Canditos/GLICOMETER/docs/assets/bateria_21700_interior.png

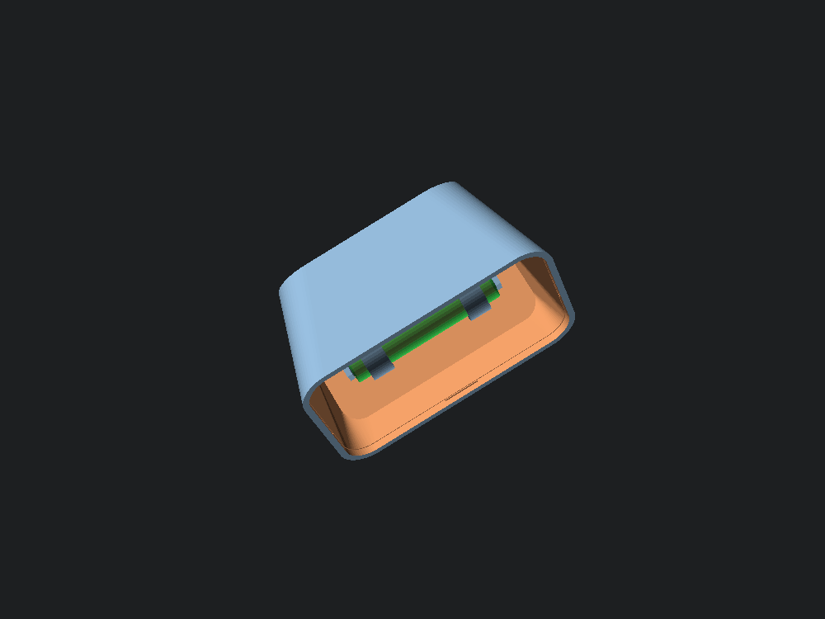
docs/assets/bateria_21700_interior.png
