Canditos/GLICOMETER/docs/assets/corpo_deitado_stl_interior.png

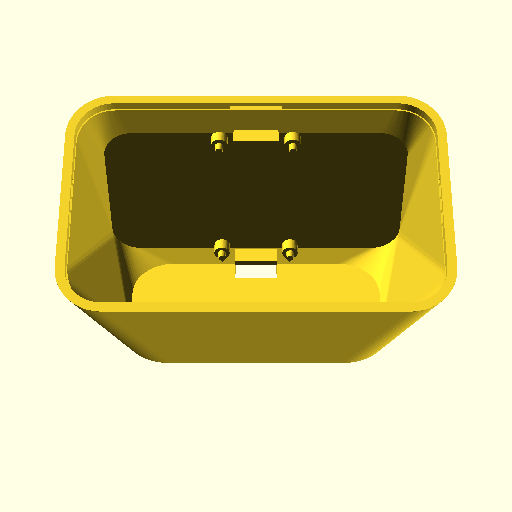
docs/assets/corpo_deitado_stl_interior.png
