Canditos/GLICOMETER/docs/assets/grelha_speaker_traseira.png

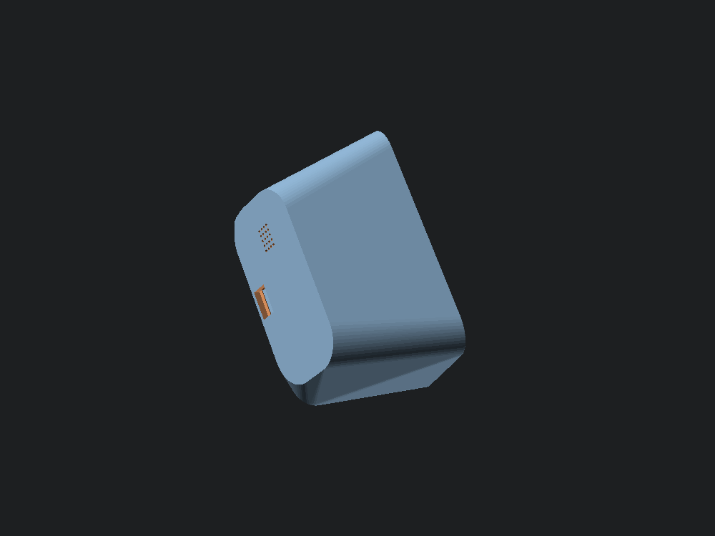
docs/assets/grelha_speaker_traseira.png
