Canditos/GLICOMETER/docs/assets/moldura_43_polegadas.png

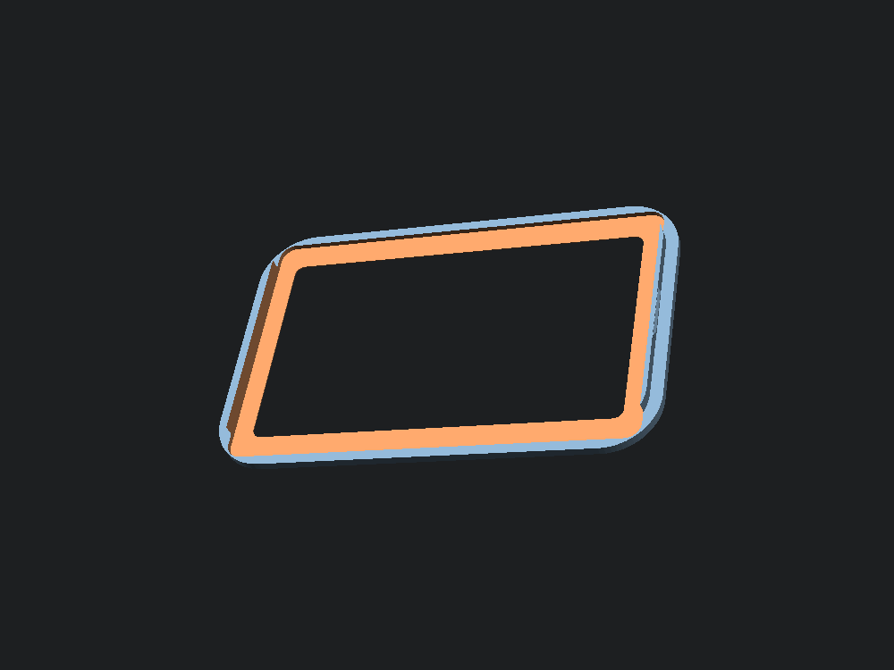
docs/assets/moldura_43_polegadas.png
