Canditos/GLICOMETER/docs/assets/moldura_frente_lisa.png

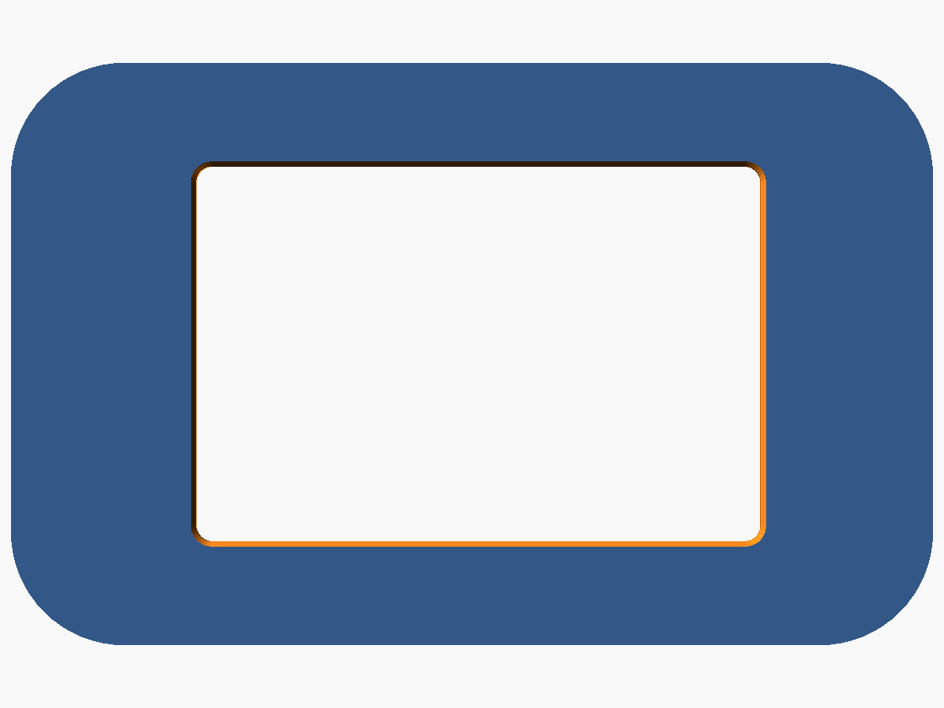
docs/assets/moldura_frente_lisa.png
