Canditos/GLICOMETER/docs/previews/preview_corpo.png

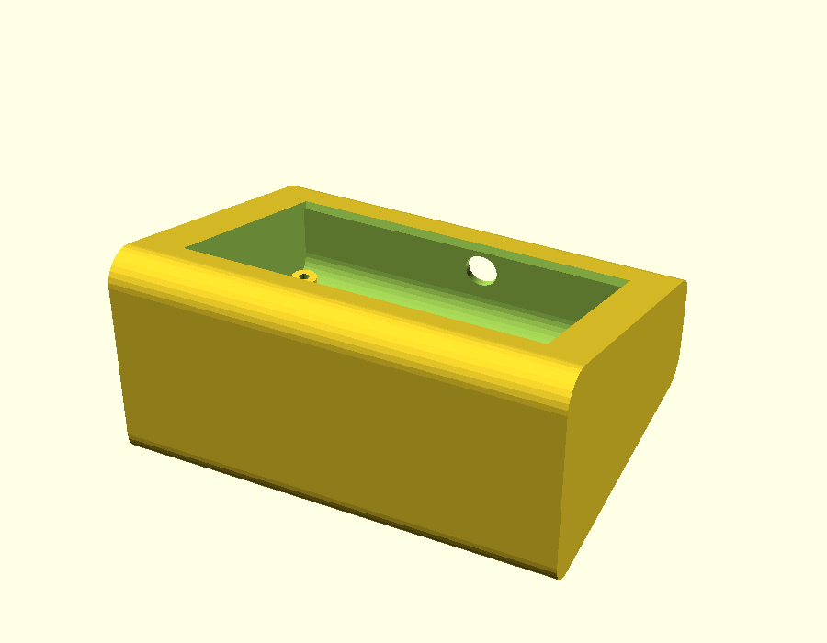
docs/previews/preview_corpo.png
