Canditos/GLICOMETER/docs/previews/preview_placa.png

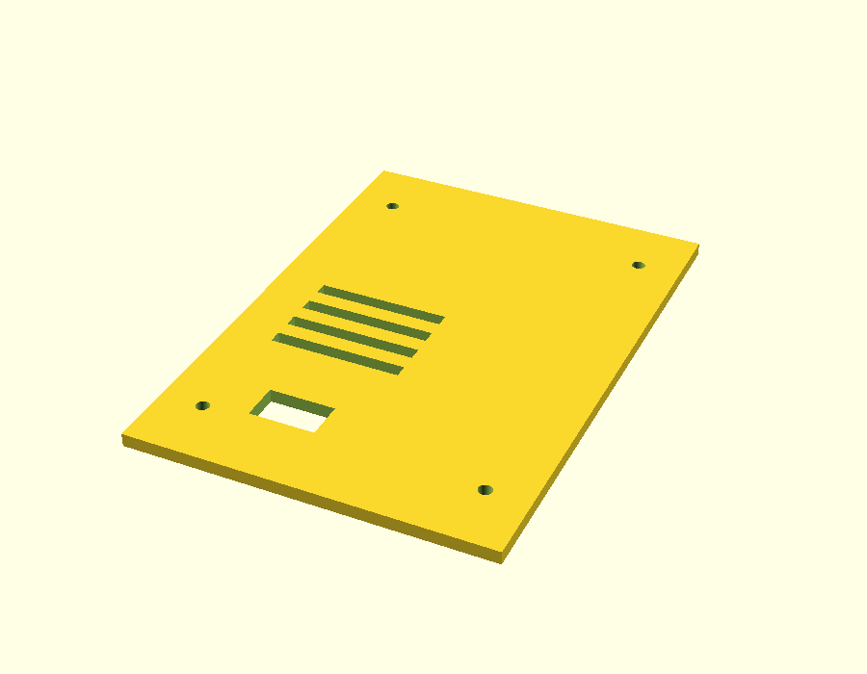
docs/previews/preview_placa.png
