Canditos/GLICOMETER/modelo-3d/moldura_v2_back.png

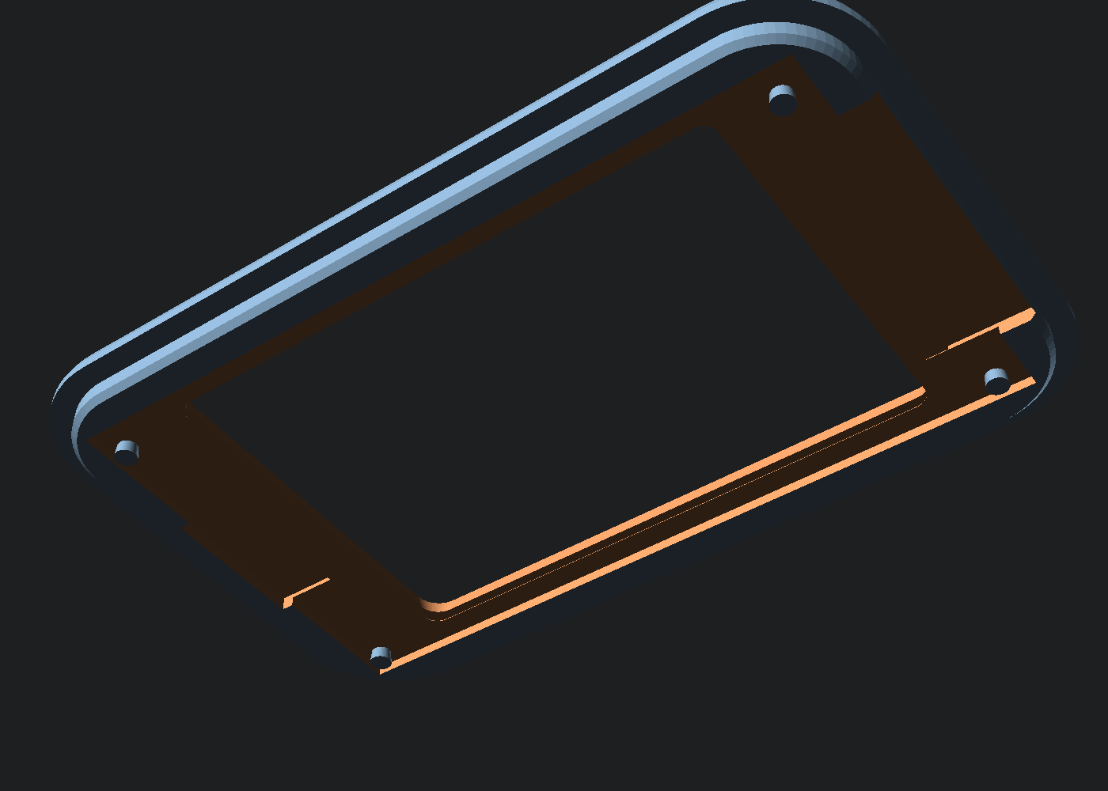
modelo-3d/moldura_v2_back.png
