Canditos/GLICOMETER/modelo-3d/moldura_v2_front.png

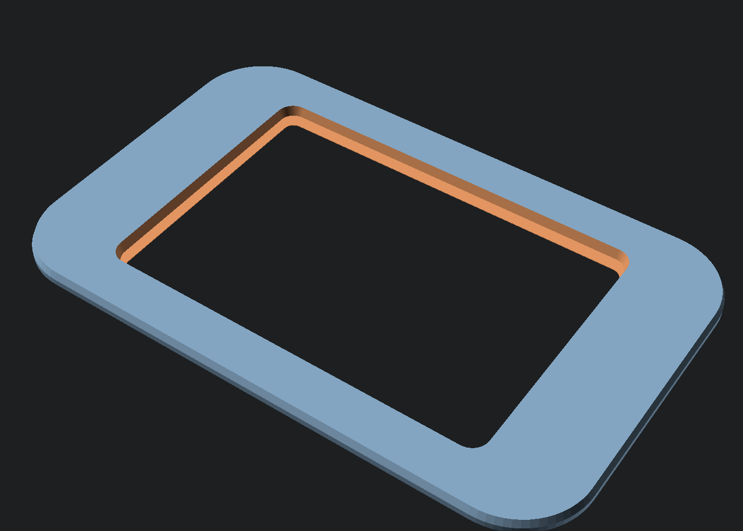
modelo-3d/moldura_v2_front.png
