Canditos/GLICOMETER/modelo-3d/stl/moldura_frontal.stl

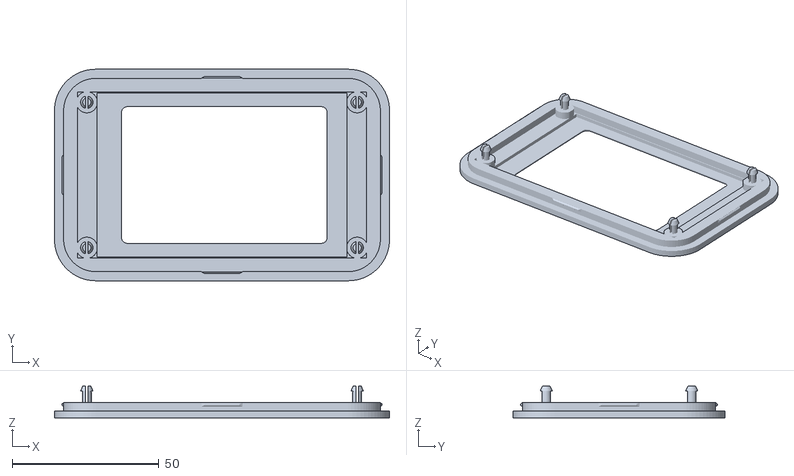
[picture p17: CAD file, 2026-10-11]
modelo-3d/stl/moldura_frontal.stl
114.0 x 72.0 x 10.8
