Canditos/GLICOMETER/modelo-3d/stl/corpo_deitado.stl

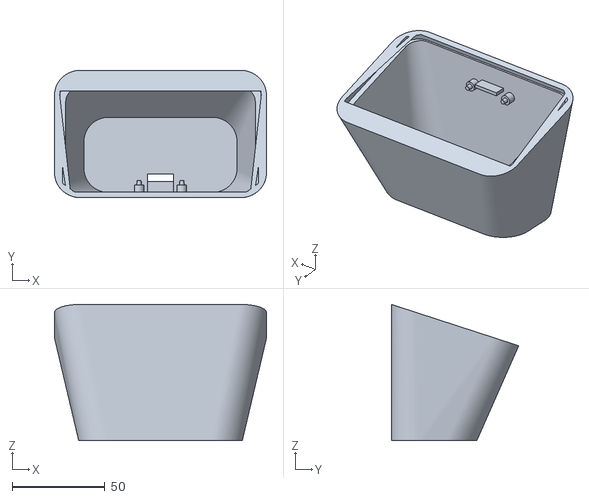
[picture p18: CAD file, 2026-10-11]
modelo-3d/stl/corpo_deitado.stl
114.0 x 68.5 x 73.2
