Canditos/GLICOMETER/modelo-3d/stl/clips_retencao_lcd.stl

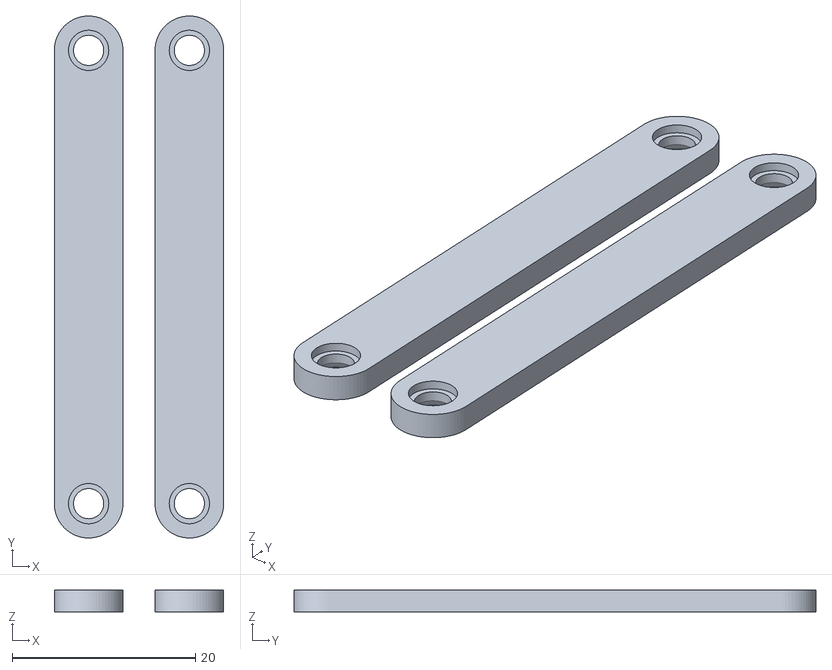
[picture p19: CAD file, 2026-10-11]
modelo-3d/stl/clips_retencao_lcd.stl
18.5 x 57.0 x 2.40
