Canditos/GLICOMETER/modelo-3d/stl/organizador_cabos.stl

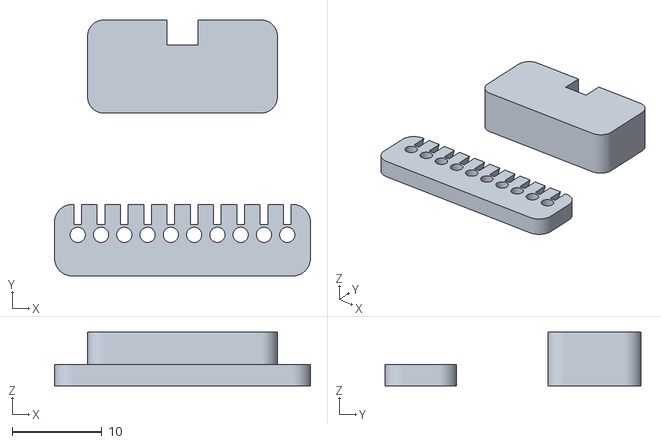
[picture p20: CAD file, 2026-10-11]
modelo-3d/stl/organizador_cabos.stl
28.6 x 28.6 x 6.00
