Canditos/GLICOMETER/modelo-3d/stl/corpo_glicometer.stl

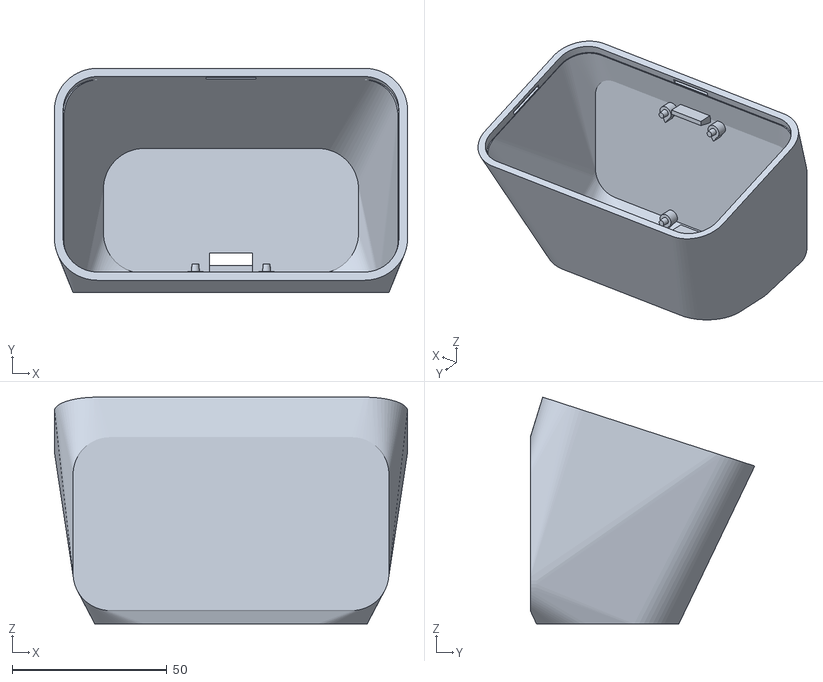
[picture p21: CAD file, 2026-10-11]
modelo-3d/stl/corpo_glicometer.stl
114.0 x 72.5 x 73.2
