Canditos/GLICOMETER/modelo-3d/preview_torres.scad

$fn = 64;
use <export_corpo_final.scad>
color([0.38, 0.42, 0.48, 1.0]) corpo_clean();
