Canditos/GLICOMETER/modelo-3d/test_corpo_pe.scad

$fn = 64;
use <export_corpo.scad>
color([0.35, 0.38, 0.44, 1.0]) corpo_clean();
