Canditos/GLICOMETER/(list of files, cad)

Other CAD files:
modelo-3d/export_corpo_nosupport.scad
modelo-3d/glicometer_master_final.scad
modelo-3d/glicometer_master_v2.scad
modelo-3d/preview_montagem_mecanica.scad
modelo-3d/test_corpo_v2_snap.scad
modelo-3d/test_flat_bottom.scad
modelo-3d/test_zero_overhang.scad
