Canditos/GLICOMETER/modelo-3d/vista_explodida_montagem.png

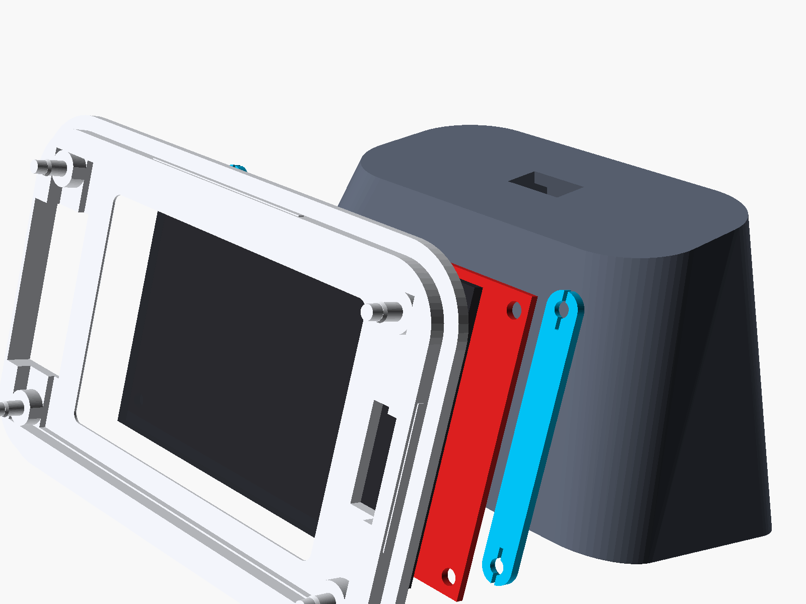
modelo-3d/vista_explodida_montagem.png
