Canditos/GLICOMETER/(list of files, drawings)

Other design files:
hardware/pcb/easyeda/glicometer_pro_easyeda.json
hardware/pcb/easyeda/glicometer_schematic_netlist.json
