Canditos/GLICOMETER/(commit log)

2026-10-06 GLICOMETER: sinalizador de glucose bedside - ESP32 + TFT 2.8in retrato + caixa 3D (firmware, modelo-3d, docs, BOM, simulacao)
    [corpo.stl, placa_traseira.stl, sinalizador_glucose.scad]
2026-10-06 premium: glow ambiente (NeoPixel), caixa menor/canelada, driver ILI9341 2.8in, mockup premium
    [corpo.stl, sinalizador_glucose.scad]
2026-10-06 premium 3d: monolito suave (r=8, frente 20 graus), glow slot na base, FLUTES opcional, $fn=96
    [corpo.stl, sinalizador_glucose.scad]
2026-10-06 caixa: monolito liso seguro (peca unica); sulcos canelados documentados como opcao (parede fina limita profundidade)
    [corpo.stl, sinalizador_glucose.scad]
2026-10-07 upgrade 3.5in: ecra 480x320 horizontal (ILI9488), dashboard 2 paineis lado a lado, caixa paisagem, mockup premium horizontal
    [corpo.stl, placa_traseira.stl, sinalizador_glucose.scad]
2026-10-11 feat: complete v2.1 pro redesign - zero-support chassis, snap-fit bezel, petg clips, cable comb, documentation & web showcase
    [clips_retencao_lcd.stl, corpo.stl, corpo_deitado.stl, corpo_glicometer.stl, export_clips.scad, export_corpo.scad, export_corpo_back.scad, export_corpo_final.scad]
2026-10-11 feat(commercial): add carrier board PCB specification and zero-code captive portal module for consumer onboarding
2026-10-11 feat(pcb): add complete all-in-one ESP32-S3 PCB schematic guide and LCSC SMT BOM for JLCPCB manufacturing
    [bom_lcsc.csv]
2026-10-11 feat(pcb): upgrade to ESP32-C5 Dual-Band (2.4GHz + 5GHz Wi-Fi 6) module with native USB and full LCSC SMT BOM
    [bom_lcsc.csv]
2026-10-11 feat(hardware): integrate digital I2S voice hardware subsystem (MEMS mic + MAX98357A amplifier) for future voice control via OTA
    [bom_lcsc.csv]
2026-10-11 feat(3d): integrate acoustic speaker chamber and rear sound grill for 1511 speaker module in body enclosure
    [export_corpo.scad]
2026-10-11 feat(3d): integrate 21700 (5000 mAh) battery snap-in cradle into body base for multi-day autonomy
    [export_corpo.scad]
2026-10-11 feat(3d): integrate solderless keystone spring contact slots for 21700 battery holder
    [export_corpo.scad]
2026-10-11 feat(hardware): add EasyEDA project descriptor and step-by-step import instructions for one-click JLCPCB ordering
    [glicometer_pro_easyeda.json]
2026-10-11 feat(pcb): add complete automated Netlist and component interconnects for EasyEDA and JLCPCB
    [glicometer_schematic_netlist.json]
2026-10-11 feat(3d): upgrade front bezel to edge-to-edge 4.3 inch IPS display with minimal borders
    [export_moldura.scad]
2026-10-11 feat(3d): integrate ergonomic top snooze button cutout into body enclosure
    [export_corpo.scad]
2026-10-11 feat(pcb): update complete JLCPCB schematic guide, LCSC BOM and Netlist for 4.3 inch IPS display with 40-pin FPC connector
    [bom_lcsc.csv]
2026-10-11 feat(pcb): generate production-ready Gerber, BOM and CPL pick-and-place package for JLCPCB automated SMT manufacturing
    [BOM-GLICOMETER-PRO.csv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]
