Canditos/GLICOMETER/(notices)

Notices in the files:
README.md:
License: MIT
